cgzjs/InkMate-/docs/PERMISSIONS.md

# 使用说明

**请勿用于商业项目。**

第三方库、词库和参考资料的来源见 [THIRD_PARTY_NOTICES.md](../THIRD_PARTY_NOTICES.md)，原有许可文件随相应内容保留。
