cgzjs/InkMate-/docs/images/button_section_comparison.png

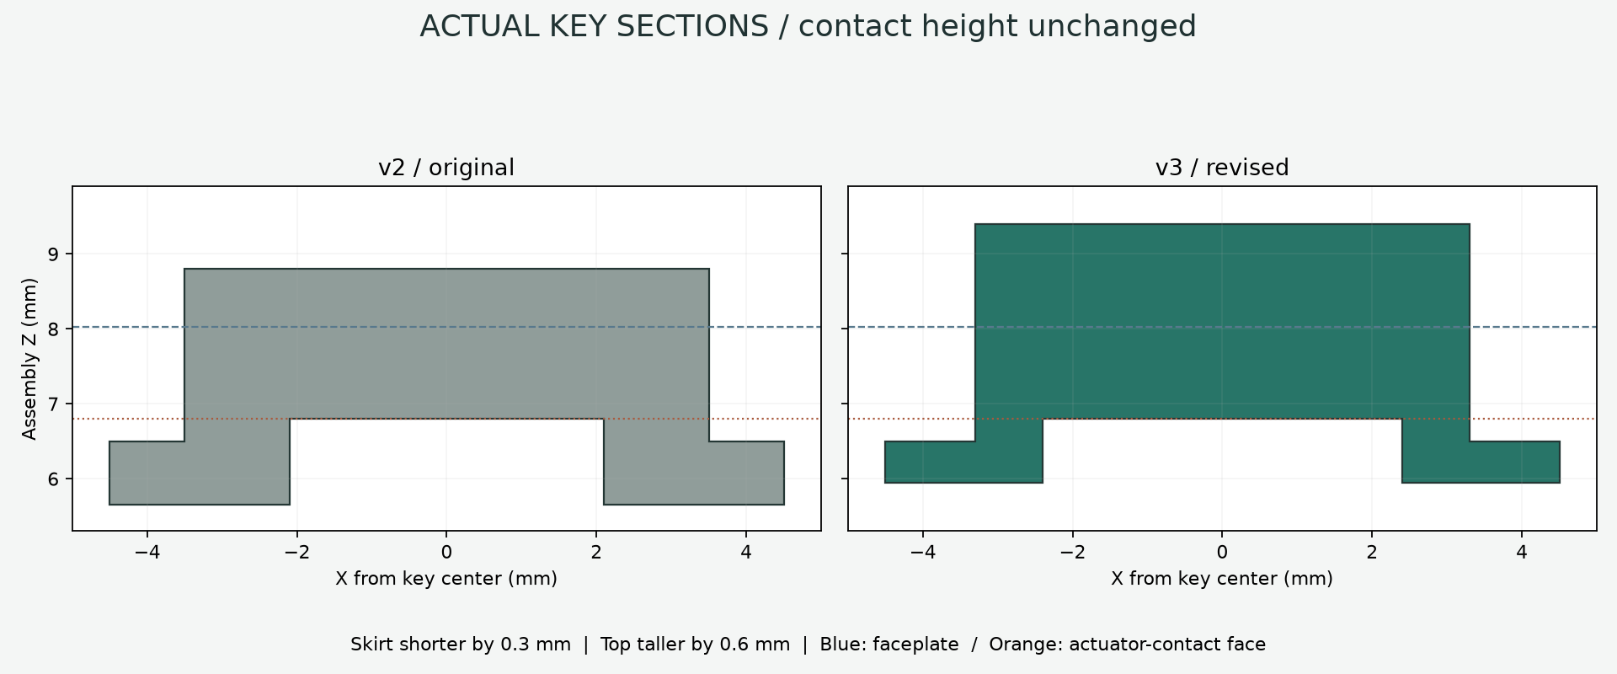
docs/images/button_section_comparison.png
