cgzjs/InkMate-/docs/images/lanyard_detail.png

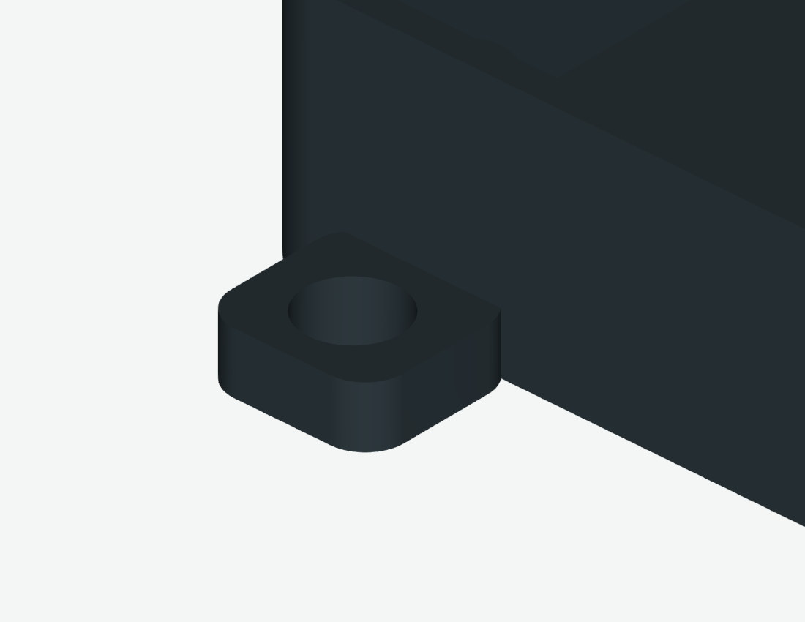
docs/images/lanyard_detail.png
