cgzjs/InkMate-/docs/images/lid_screen_pocket.png

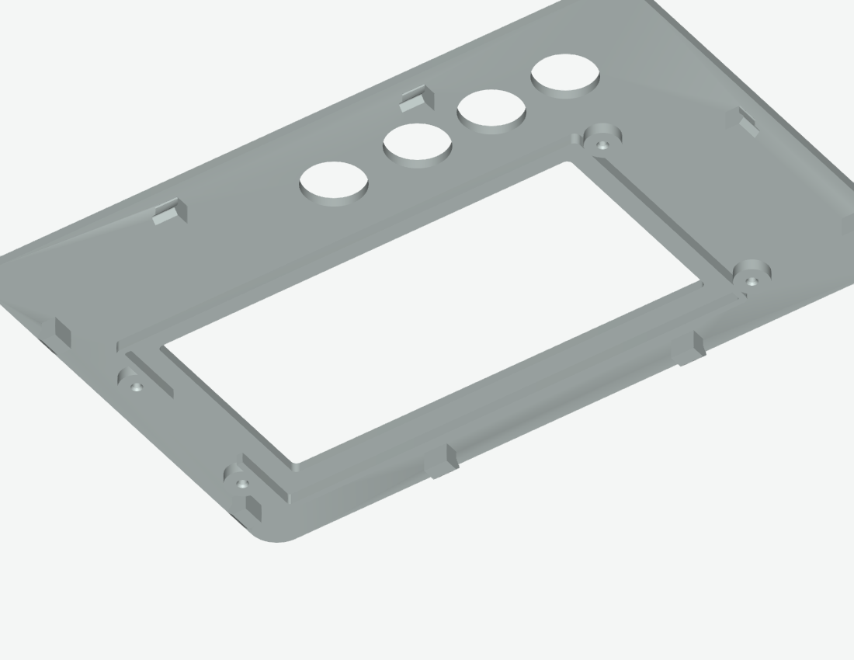
docs/images/lid_screen_pocket.png
