cgzjs/InkMate-/enclosure/v3/source/reference_v2/button_SW4_assembly.stl

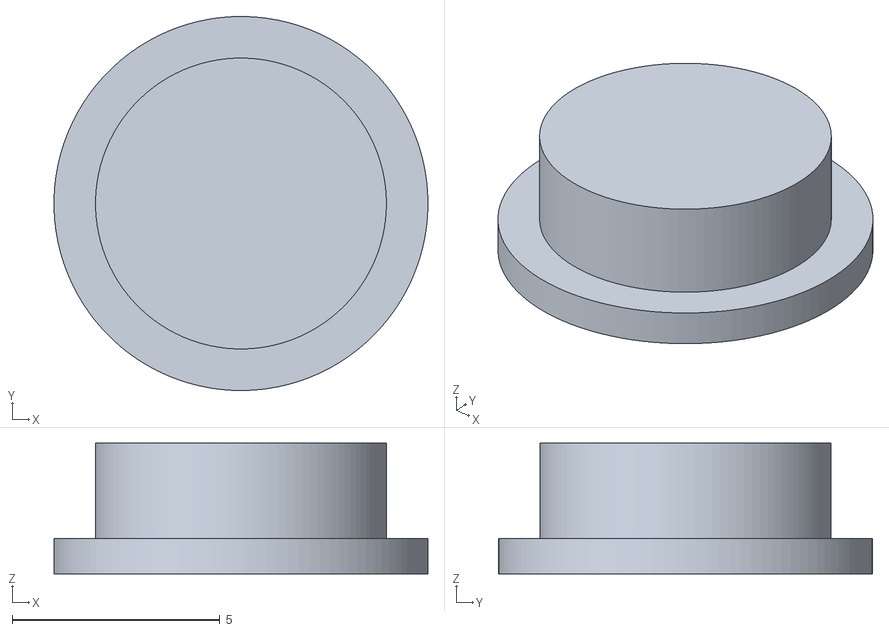
[picture p6: CAD file, 2026-10-16]
enclosure/v3/source/reference_v2/button_SW4_assembly.stl
9.00 x 9.00 x 3.15
