cgzjs/InkMate-/enclosure/v3/print/front_lid_print.stl

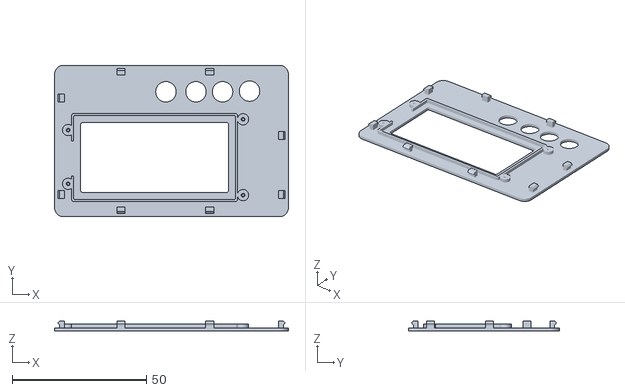
[picture p7: CAD file, 2026-10-16]
enclosure/v3/print/front_lid_print.stl
87.1 x 56.4 x 3.71
