cgzjs/InkMate-/enclosure/v3/source/reference_BBV3.step

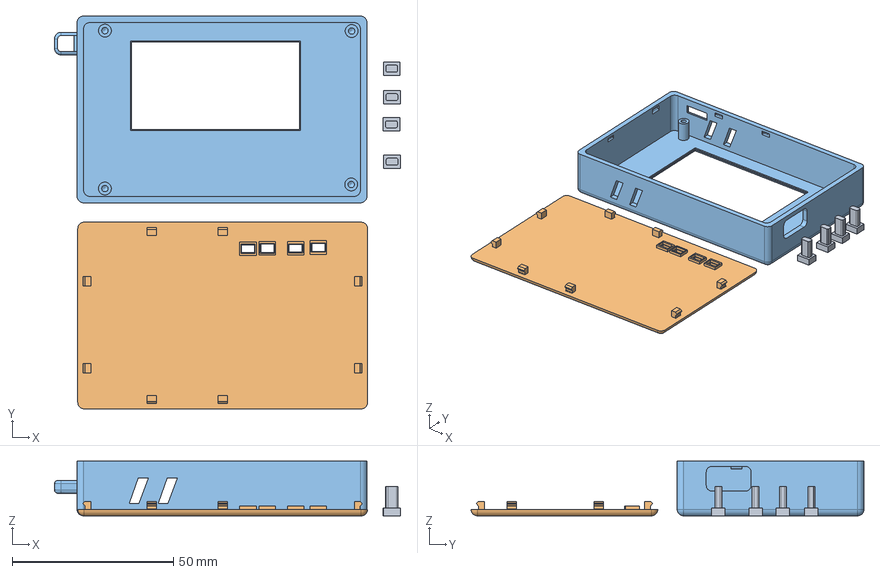
[picture p8: CAD file, 2026-10-16]
enclosure/v3/source/reference_BBV3.step
107.4 x 121.9 x 17.0 mm
