cgzjs/InkMate-/enclosure/v3/source/reference_v2/base.step

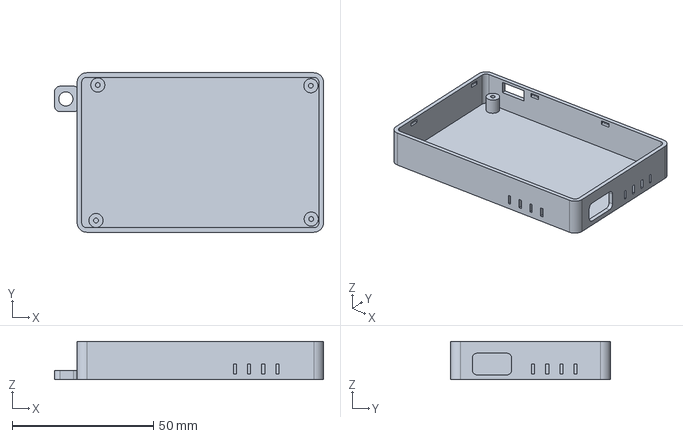
[picture p9: CAD file, 2026-10-16]
enclosure/v3/source/reference_v2/base.step
95.1 x 56.4 x 13.6 mm
