cgzjs/InkMate-/hardware/reference/BB2V1.step

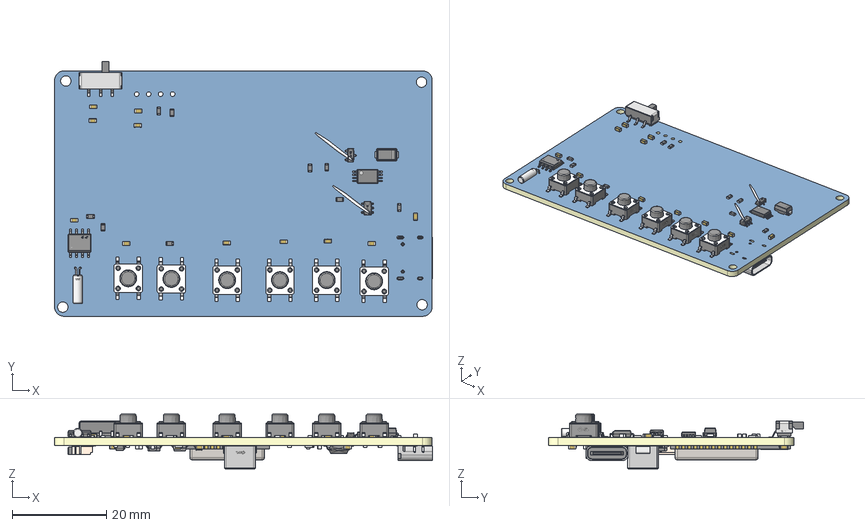
[picture p10: CAD file, 2026-10-16]
hardware/reference/BB2V1.step
80.0 x 53.9 x 11.6 mm
Board~3372
SMA_L4.2-W2.6-LS5.0-RD_1~SMA_L4.2-W2.6-LS5.0-RD_1~Mfps
TSSOP-8_L4.4-W3.0-P0.65-LS6.4-BL~TSSOP-8_L4.4-W3.0-P0.65-LS6.4-BL-2~l 4TD
IND-SMD_L7.1-W6.6_H5.0~IND-SMD_L7.1-W6.6-H5.0~ZZ0R
R0603~R0603~6oSw x 20
C0603~C0603_L1.6-W0.8-H0.8~1pBj x 28
SW-SMD_SK-32455-L3-A~SW-SMD_SK-32455-L3-A~vftN
SW-SMD_4P-L6.0-W6.0-P4.50-LS9.0_H5.0~SW-SMD_4P-L6.0-W6.0-P4.50-LS9.0_ H5.0~0Mz7 x 6
SOT-23-5_L2.9-W1.6-P0.95-LS2.8-BR~SOT-23-5_L2.9-W1.6-P0.95-LS2.8-BR~O ulx
WIFI-SMD_ESP32-WROOM-32E~WIFI-SMD_L25.5-W18.0-H3.1-ESP32-WROOM-32E~Do Ft
SOP-8_L4.9-W3.9-P1.27-LS6.0-BL~SOP-8_L4.9-W3.9-P1.27-LS6.0-BL-1~CNkY
USB-C-SMD_TYPE-C-16PIN-2MD-073~USB-C-SMD_TYPE-C-6PIN-2MD-073~0USG
SOT-23-3_L2.9-W1.3-P1.90-LS2.4-BR~SOT-23-3P_L2.9-W1.3-H1.0-LS2.4-P0.9 5~GqDX x 2
OSC-TH_BD2.0-P0.70-D0.3~OSC-TH_D2.0-W6.0-P0.70~NCkB
SOD-123_L2.8-W1.8-LS3.7-RD~SOD-123_L2.8-W1.8-LS3.7-RD~C54b x 3
SOT-23-6_L2.9-W1.6-P0.95-LS2.8-BL~SOT-23-6_L2.9-W1.6-H1.5-LS2.8-P0.95 ~fszM
ESOP-8_L4.9-W3.9-P1.27-LS6.0-BL-EP~ESOP-8_L4.9-W3.9-H1.6-LS6.0-P1.27~ eZ9Q
FPC-SMD_24P-P0.50_FPC24-T1S1-2030-A~FPC-SMD_24P-P0.50_FPC24-T1T1-2020 -A~eOXl
