cgzjs/InkMate-/enclosure/v3/print/screen_retainer_print.stl

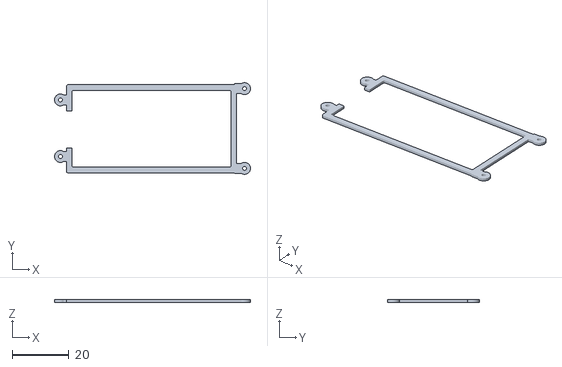
[picture p11: CAD file, 2026-10-16]
enclosure/v3/print/screen_retainer_print.stl
69.3 x 32.4 x 0.9
