cgzjs/InkMate-/enclosure/v3/step/button_SW5.step

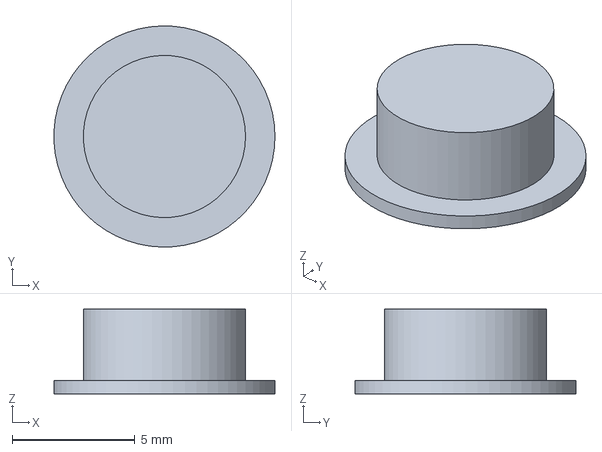
[picture p12: CAD file, 2026-10-16]
enclosure/v3/step/button_SW5.step
8.99 x 9.00 x 3.45 mm
