cgzjs/InkMate-/enclosure/v3/print/button_SW5_print.stl

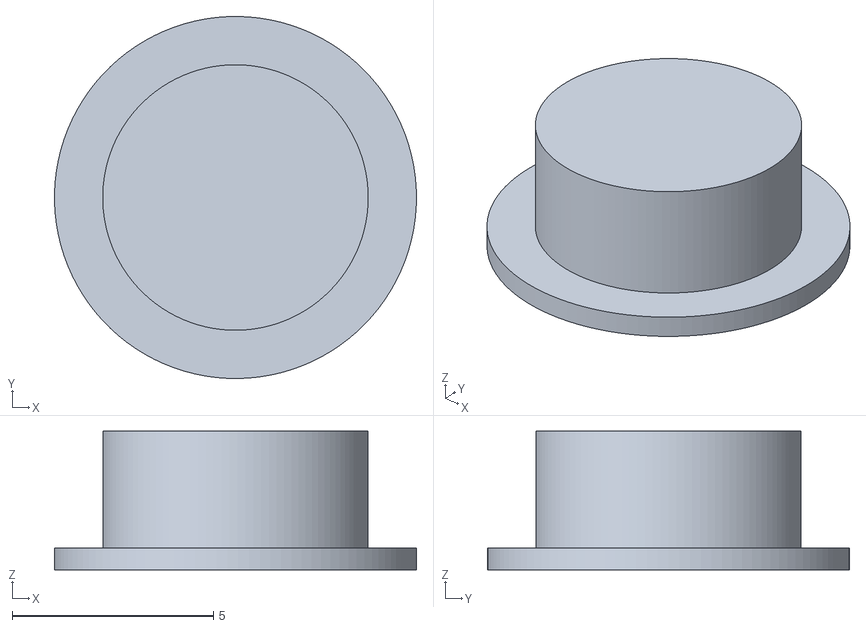
[picture p13: CAD file, 2026-10-16]
enclosure/v3/print/button_SW5_print.stl
9.00 x 9.00 x 3.45
