cgzjs/InkMate-/enclosure/v3/step/BB2V1_thin_shell.step

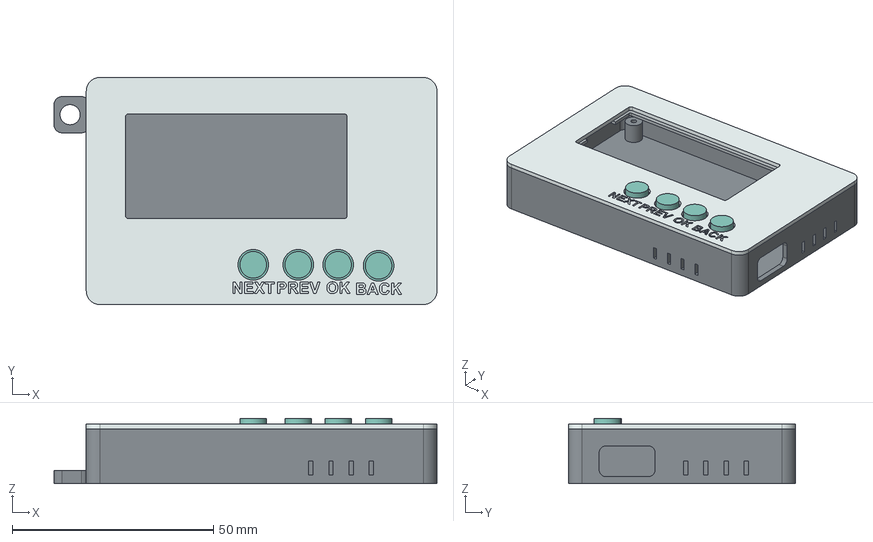
[picture p14: CAD file, 2026-10-16]
enclosure/v3/step/BB2V1_thin_shell.step
95.1 x 56.4 x 16.2 mm
base
front_lid
screen_retainer
button_SW4
button_SW8
button_SW5
button_SW2
