cgzjs/InkMate-/(list of files, cad)

Other CAD files:
enclosure/v3/step/front_lid.step
enclosure/v3/step/button_SW2.step
enclosure/v3/print/base_print.stl
enclosure/v3/step/base.step
enclosure/v3/print/button_SW2_print.stl
enclosure/v3/step/screen_retainer.step
enclosure/v3/step/button_SW4.step
enclosure/v3/step/button_SW8.step
