cgzjs/InkMate-/firmware/CyberFortune_CZ04_2Buttons/icons.h

#ifndef CYBER_FORTUNE_ICONS_H
#define CYBER_FORTUNE_ICONS_H

#include <Arduino.h>
#include <pgmspace.h>

#define ICON_W 56
#define ICON_H 56
#define ICON_BYTES 784

static const uint8_t icon_tarot_fool[] PROGMEM = {
  0xFF, 0xFF, 0xFF, 0xFF, 0xFF, 0xFF, 0xFF, 0xFF, 0xFF, 0xFF, 0xFF, 0xFF, 0xFF, 0xFF, 0xFF, 0xFF,
  0xFD, 0x15, 0x55, 0x55, 0x55, 0x55, 0x55, 0x55, 0x51, 0xFF, 0xFF, 0xFF, 0xFF, 0xFF, 0xF5, 0xAA,
  0xAA, 0xAA, 0xAA, 0xAA, 0xAA, 0xAA, 0xA9, 0x7F, 0xFF, 0xFF, 0xFF, 0xFF, 0xF6, 0x59, 0x55, 0x55,
  0x55, 0x56, 0xA5, 0x19, 0x56, 0x7F, 0xFF, 0xFF, 0xFF, 0xFF, 0xF6, 0x7F, 0xFF, 0xFF, 0xFF, 0xFE,
  0xAA, 0x6F, 0xFA, 0x7F, 0xFF, 0xFF, 0xFF, 0xFF, 0xF6, 0xBF, 0xFF, 0xFF, 0xFE, 0xBE, 0xAA, 0x9F,
  0xF9, 0x7F, 0xFF, 0xFF, 0xFF, 0xFF, 0xF6, 0xBF, 0xFF, 0xFF, 0xFD, 0x7F, 0xEA, 0x9B, 0xF9, 0x7F,
  0xFF, 0xFF, 0xFF, 0xFF, 0xF6, 0xBF, 0xFF, 0xFF, 0xFF, 0xFF, 0x9B, 0xA5, 0xA6, 0x7F, 0xFF, 0xFF,
  0xFF, 0xFF, 0xF6, 0xBF, 0xFF, 0xFF, 0xFF, 0xFF, 0xBD, 0xA9, 0x52, 0x7F, 0xFF, 0xFF, 0xFF, 0xFF,
  0xF6, 0xBF, 0xFF, 0xFF, 0xFF, 0xFF, 0xFA, 0xDA, 0x96, 0x7F, 0xFF, 0xFF, 0xFF, 0xFF, 0xF6, 0xBF,
  0xFF, 0xFF, 0xFE, 0x41, 0xFF, 0x6A, 0xA6, 0x7F, 0xFF, 0xFF, 0xFF, 0xFF, 0xF6, 0xBF, 0xFF, 0xFF,
  0xE0, 0x14, 0xBF, 0xBA, 0xA6, 0x7F, 0xFF, 0xFF, 0xFF, 0xFF, 0xF6, 0xBF, 0xFF, 0xFF, 0xD0, 0x14,
  0xBF, 0xAB, 0x66, 0x7F, 0xFF, 0xFF, 0xFF, 0xFF, 0xF6, 0xBF, 0xFF, 0xFF, 0x9A, 0x02, 0xFD, 0x12,
  0x7A, 0x7F, 0xFF, 0xFF, 0xFF, 0xFF, 0xF6, 0xBF, 0xFF, 0xFF, 0xAF, 0x43, 0xE4, 0x1B, 0x7A, 0x7F,
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
  0x87, 0xFF, 0xFE, 0x92, 0xAF, 0xFF, 0xFF, 0xE3, 0xCB, 0xFE, 0x07, 0xF8, 0x5A, 0xA6, 0x0F, 0xFF,
  0xFD, 0x8B, 0xFF, 0xC7, 0xFF, 0xE3, 0xCB, 0xFE, 0xBF, 0xBE, 0x40, 0x59, 0x2A, 0xAF, 0xFD, 0x8F,
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
};
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
