cgzjs/InkMate-/firmware/CyberFortune_CZ04_2Buttons/weather.h

const uint8_t Weather32x32[]={
0x00,0x00,0x00,0x00,0x00,0x00,0x00,0x00,0x00,0x00,0x80,0x00,0x00,0x00,0x80,0x00,
0x00,0x00,0x80,0x00,0x00,0x00,0x80,0x00,0x08,0x00,0x00,0x20,0x04,0x00,0x00,0x40,
0x02,0x07,0xE0,0x80,0x01,0x0C,0x11,0x00,0x00,0x30,0x0C,0x00,0x00,0x20,0x04,0x00,
0x00,0x40,0x02,0x00,0x00,0x40,0x02,0x00,0x00,0x80,0x01,0x00,0x00,0x80,0x01,0x00,
0x3C,0x80,0x01,0x3C,0x00,0x80,0x01,0x00,0x00,0x40,0x02,0x00,0x00,0x40,0x02,0x00,
0x00,0x20,0x04,0x00,0x00,0x30,0x0C,0x00,0x00,0x0C,0x30,0x00,0x00,0x43,0xC1,0x00,
0x00,0x80,0x00,0x80,0x01,0x00,0x00,0x40,0x02,0x00,0x80,0x20,0x00,0x00,0x80,0x00,
0x00,0x00,0x80,0x00,0x00,0x00,0x80,0x00,0x00,0x00,0x00,0x00,0x00,0x00,0x00,0x00,/*"C:\Users\Administrator\Desktop\天气\白天晴.bmp"*/
0x00,0x00,0x00,0x00,0x00,0x00,0x00,0x00,0x00,0x00,0x00,0x00,0x00,0x00,0x00,0x00,
0x00,0x00,0x00,0x00,0x00,0x00,0x00,0x00,0x00,0x03,0xE0,0x00,0x00,0x04,0x10,0x00,
0x00,0x08,0x08,0x00,0x00,0x10,0x04,0x00,0x00,0x10,0x04,0x00,0x00,0x20,0x02,0x00,
0x01,0xC0,0x01,0x80,0x02,0x00,0x00,0x40,0x04,0x00,0x00,0x20,0x08,0x00,0x00,0x10,
0x08,0x00,0x00,0x10,0x04,0x00,0x00,0x20,0x02,0x00,0x00,0x60,0x01,0xE0,0x07,0x80,
0x00,0x1F,0xF8,0x00,0x00,0x00,0x00,0x00,0x00,0x22,0x22,0x00,0x00,0x44,0x44,0x00,
0x00,0x88,0x88,0x00,0x00,0x00,0x00,0x00,0x00,0x00,0x00,0x00,0x00,0x00,0x00,0x00,
0x00,0x00,0x00,0x00,0x00,0x00,0x00,0x00,0x00,0x00,0x00,0x00,0x00,0x00,0x00,0x00,/*"C:\Users\Administrator\Desktop\天气\暴雨.bmp"*/
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
0x00,0x1F,0xF8,0x00,0x00,0x00,0x00,0x00,0x00,0x02,0x20,0x00,0x00,0x04,0x40,0x00,
0x00,0x08,0x80,0x00,0x00,0x00,0x00,0x00,0x00,0x00,0x00,0x00,0x00,0x00,0x00,0x00,
0x00,0x00,0x00,0x00,0x00,0x00,0x00,0x00,0x00,0x00,0x00,0x00,0x00,0x00,0x00,0x00,/*"C:\Users\Administrator\Desktop\天气\中雨.bmp",*/
};
